arampersand/tasky/context/notes.md

```
---

## 🧪 Estado
- [x] Create core structure (`model`, `ui`, `wifi_portal`).
- [x] Centralize `enterScreen` logic.
- [x] Adapt to circular display (added `drawFrame` abstraction).
- [x] Fix QR screen blank issue (via `enterScreen`).
- [x] Fix LED on encoder issue (via `uiHaptic`).
- [x] Resolve C/C++ library conflicts with Nayuki QR code generator.
- [ ] Verify compilation and functionality on hardware.

---

## 📝 Licencia

Proyecto personal / experimental.  
Uso libre para aprendizaje y prototipos.

---

## ✨ Autor

Desarrollado por **Ary**  
Tasky – *Every second counts.*
