arampersand/tasky/cursor_context/00_MASTER_CONTEXT.md

# TaskyCircular – Master Context

TaskyCircular es un firmware para un dispositivo físico de productividad
con pantalla circular 240x240, encoder y WiFi.

Este proyecto está en transición de:
- Firmware funcional
→ Producto pulido con UX clara, animaciones y arquitectura mantenible.

NO es un experimento.
SÍ es un producto en camino a mercado.
