arampersand/tasky/cursor_context/01_PRODUCT_VISION.md

# Product Vision – Tasky

Tasky es un dispositivo de escritorio que hace visible:
- Tu foco
- Tus tareas
- Tu constancia (streak)

Sin depender del teléfono.

Principios:
- Calm tech
- Minimalismo funcional
- Todo feedback debe sentirse intencional
- El usuario nunca debe dudar qué hace el encoder
