arampersand/tasky/cursor_context/05_CONSTRAINTS.md

# Constraints

- Arduino IDE compatible (ESP32 core)
- No external frameworks
- No dynamic memory heavy solutions
- Prefer clarity over cleverness
- Keep modules separate (.h/.cpp)
- Avoid global drawing side effects
