arampersand/tasky/companion/README.md

# Tasky companion: AI agents on your desk

For **Tasky 3.0** or newer (or the 2.12+ **Tasky for Agents** firmware). Your coding agents report what they're doing, and Tasky shows it:

- **Agents** screen (it joins the MODE carousel when the first card arrives): one card per session with a little robot that shows its state (working / **waiting for you** / done) and the last message. Turn to go through the cards.
- **Approve from the knob:** when Claude Code asks permission ("run `npm test`?", "edit `ui.cpp`?"), Tasky jumps to that card. **Turn** to pick *Allow*, *Deny* or *Allow edits*, **press** to answer. **Long press** leaves the question to the terminal.
- The **light bar breathes** while an agent waits for you, plus a short beep (muted during focus sessions).
- **Home** says "1 agent needs you" instead of the phrase.

Tasky talks over the USB cable or, once paired, **over Wi-Fi**: plug it into the computer once and from then on it also works unplugged, on battery, anywhere on the same network (Tasky 3.1+).

## Set up (macOS / Linux)

1. Flash **Tasky 3.0 or newer** (or Tasky for Agents 2.12+) from https://tasky-flash.vercel.app.
2. Install the Tasky plugin. In Claude Code, run:
   ```
   /plugin marketplace add arampersand/tasky
   /plugin install tasky@tasky
   ```
3. Restart Claude Code. With Tasky plugged in, it shows a **Ready** card.

Something not working? Run `/tasky:status` in Claude Code: it checks everything and says what to fix.

The plugin lives in [`claude-plugin/`](../claude-plugin): six hooks, the `/tasky:status` skill and `tasky_agent.py`. Updates come through `/plugin`. To remove it: `/plugin uninstall tasky@tasky`.

Only Python 3 is needed (macOS: `xcode-select --install` if `python3` is missing). **Windows:** install Python from python.org (it brings the `py` launcher) and Git for Windows: Claude Code runs the plugin's hooks in Git Bash, and `hooks/run.sh` finds Python with `py -3`. Tasky shows up as a COM port (no driver needed on Windows 10/11). Tested with Claude Code 2.1.280; if hooks don't fire on an older version, update Claude Code (`claude update`).

### Without the plugin (terminal)

```bash
curl -fsSL https://tasky-flash.vercel.app/agents/install.sh | sh
```

It puts `tasky_agent.py` in `~/.tasky/` and adds the same hooks to `~/.claude/settings.json`. It backs the file up first (`settings.json.tasky-backup`) and leaves your other settings and hooks alone. Running it again updates it. To remove it: `curl -fsSL https://tasky-flash.vercel.app/agents/install.sh | sh -s -- --uninstall`

Use the plugin **or** the installer, not both: with both, every event reaches Tasky twice. If you switch to the plugin, run the uninstall command above (`tasky_agent.py doctor` warns about duplicate hooks).

| Claude Code event | What Tasky does |
|---|---|
| `SessionStart` | card: Ready |
| `UserPromptSubmit` | card: working |
| `PermissionRequest` | the question on the card: allow / deny with the knob |
| `Notification` (permission or input needed) | card: **waiting**, the light breathes |
| `Stop` | card: done |
| `SessionEnd` | card removed |

Sessions are named after the project folder. Tasky keeps up to 4 and forgets ones with no news for 2 hours.

### About approvals

- Claude Code runs the permission hook **before** it shows its own prompt. While a question is on Tasky, the terminal waits for it: up to **60 s** (`TASKY_ASK_TIMEOUT`), then the normal prompt appears. A long press on Tasky sends it to the terminal at once.
- If Tasky isn't plugged in, the hook returns immediately and you get the normal prompt. Nothing is ever approved by itself.
- *Allow edits* (for Edit/Write) also switches that session to accept edits, like choosing it in the terminal.
- Tasky can't answer Claude's multiple-choice questions or send it new messages: Claude Code hooks don't allow that.
- Anyone who can press the knob can approve. Keep that in mind on a shared desk.

## How it works

**Wi-Fi.** When Tasky 3.1+ is on USB, the daemon saves its pairing (device id and a random token) in `~/.tasky/link.json`, readable only by you. When Tasky isn't on USB, the daemon connects to it over TCP port 7778 and sends the token first; if Tasky's address changed, a UDP broadcast on the same port finds it again. Over Wi-Fi Tasky only accepts agent cards and questions, never settings. The token travels unencrypted on your local network, like most smart-home devices: anyone on that network who captures it could send cards to your Tasky, but approving still takes the knob. Unplug and replug to re-pair after a factory reset.

`tasky_agent.py daemon` (started on demand, quits after 2 hours without news) is the only program that opens Tasky's USB port. Hooks talk to it over a Unix socket in `~/.tasky/` that only you can open. That way a question can wait for the knob while other sessions keep reporting. It never toggles the port's DTR/RTS lines, so it never resets Tasky.

## Other agents and scripts

Anything that can run a command can report (with the plugin, the script is in Claude Code's plugin folder; any copy works, e.g. the one from the manual setup below):

```bash
python3 ~/.tasky/tasky_agent.py send --id deploy --label "Prod deploy" --state working --msg "Rolling out"
python3 ~/.tasky/tasky_agent.py send --id deploy --state done
python3 ~/.tasky/tasky_agent.py status    # is Tasky connected?
```

Protocol, one line over USB serial at 115200 baud (Tasky answers with lines starting `@tasky `):

```
TASKY AGENT {"id":"deploy","label":"Prod deploy","state":"working","msg":"Rolling out"}
TASKY ASK {"id":"r1","session":"deploy","label":"Prod deploy","tool":"Bash","detail":"kubectl apply","options":["Allow","Deny"],"timeout":60}
   -> @tasky {"answer":{"id":"r1","choice":0}}     (-1 = answer in the terminal)
TASKY ASK-CANCEL {"id":"r1"}
```

`state` is `working`, `waiting`, `done` or `end`. Text is ASCII (Tasky's fonts have no accents; the script simplifies them).

<details>
<summary>Manual setup (without the plugin or the installer)</summary>

```bash
mkdir -p ~/.tasky
curl -fsSL https://raw.githubusercontent.com/arampersand/tasky/main/claude-plugin/tasky_agent.py -o ~/.tasky/tasky_agent.py
python3 ~/.tasky/tasky_agent.py install       # or merge claude-hooks.json into ~/.claude/settings.json by hand
```
</details>

## Troubleshooting

- **First step:** `/tasky:status` in Claude Code, or `python3 ~/.tasky/tasky_agent.py doctor` in a terminal. It checks Python, Tasky on USB (and who holds the port), the firmware edition and version, and the hooks, then says what to fix.
- **Nothing shows up:** close the web setup page or any serial monitor: only one program can hold the port. If several USB devices are connected, set `TASKY_PORT=/dev/cu.usbmodemXXXX`.
- **Everything shows up twice:** the plugin and `install.sh` are both installed. Keep the plugin and run `curl -fsSL https://tasky-flash.vercel.app/agents/install.sh | sh -s -- --uninstall`.
- **Logs:** `~/.tasky/daemon.log`.
- **macOS asks to "identify your keyboard"** after you pair Tasky over Bluetooth (Controls screen): close that window. Tasky's shortcuts work anyway.

## Tests

```bash
python3 -m unittest discover companion/tests
```
They run the companion against a fake Tasky on a pseudo-terminal: status, allow / deny / allow edits, Tasky missing, timeout, a killed hook, concurrent sessions, and the settings.json installer.
