arampersand/tasky/claude-plugin/skills/status/SKILL.md

---
name: status
description: Check that Tasky (the desk gadget) is connected to Claude Code, and say exactly what to fix if it isn't. Use when the user asks whether Tasky works, why their Tasky shows nothing, or how to set it up.
---

Run this and show the user its output:

```bash
sh "${CLAUDE_PLUGIN_ROOT}/hooks/run.sh" doctor
```

(`run.sh` finds Python: `python3` on macOS / Linux, the `py` launcher on Windows. If it prints nothing at all, Python 3 isn't installed: on Windows, install it from python.org; on a Mac, run `xcode-select --install`.)

Each line is a check (✓ ok, ✗ problem). If something failed, tell the user the one fix the output suggests, in plain words, and offer to run it if it's a command. Common fixes:

- **No Tasky found:** plug Tasky into this computer with a data USB-C cable. Once it has been plugged in, it also works over Wi-Fi on the same network.
- **Port busy:** close the tab of tasky-flash.vercel.app (or the app named in the output) that holds Tasky's USB port.
- **Old firmware:** update Tasky at https://tasky-flash.vercel.app (it keeps the settings). Wi-Fi needs 3.1 or newer.
- **Hooks installed twice** (this plugin and `install.sh`): run `curl -fsSL https://tasky-flash.vercel.app/agents/install.sh | sh -s -- --uninstall`.

Don't change any files yourself.
