arampersand/tasky/cursor_context/06_PROMPT_FIX_COMPILATION.md

You are a senior embedded firmware engineer.

Your task:
Make this project compile with the MINIMUM number of changes.

Rules:
- Do NOT change UX behavior unless strictly required
- Do NOT redesign architecture yet
- Fix scope issues, naming conflicts, missing definitions
- Rename project classes if they collide with ESP32 core
- Ensure all UI drawing happens inside methods
- Ensure model/UI contracts match

Deliver:
1. List of files modified
2. Explanation of each fix
3. Final corrected code per file
