arampersand/tasky/firmware/tasky/agents_sprites.h

#pragma once
// The agent character on Tasky's Agents cards: Claude Code's little pixel
// crab (from its icon, a 16x10 grid in 1.5-unit steps), animated per state.
// '#' = body, '.' = background. Drawn x5 and tinted by state.

static const int SPRITE_W = 16, SPRITE_H = 10;

static const char *const SPRITE_WORK[2][SPRITE_H] = {
    {// walking: outer legs down
     "..############..", "..############..", "..##.######.##..", "..##.######.##..",
     "################", "################", "..############..", "..############..",
     "..#.#.....#.#...", "..#.......#....."},
    {// walking: inner legs down
     "..############..", "..############..", "..##.######.##..", "..##.######.##..",
     "################", "################", "..############..", "..############..",
     "..#.#.....#.#...", "....#.......#..."}};

static const char *const SPRITE_WAIT[2][SPRITE_H] = {
    {// right arm up
     "..############.#", "..############.#", "..##.######.####", "..##.######.####",
     "##############..", "##############..", "..############..", "..############..",
     "..#.#.....#.#...", "..#.#.....#.#..."},
    {// arms out
     "..############..", "..############..", "..##.######.##..", "..##.######.##..",
     "################", "################", "..############..", "..############..",
     "..#.#.....#.#...", "..#.#.....#.#..."}};

static const char *const SPRITE_DONE[2][SPRITE_H] = {
    {// happy, eyes closed
     "..############..", "..############..", "..############..", "..##.######.##..",
     "################", "################", "..############..", "..############..",
     "..#.#.....#.#...", "..#.#.....#.#..."},
    {// same pose, drawn one row higher: a little hop
     "..############..", "..############..", "..############..", "..##.######.##..",
     "################", "################", "..############..", "..############..",
     "..#.#.....#.#...", "..#.#.....#.#..."}};
