arampersand/tasky/TaskyCircular/wifi_portal.h

#pragma once

#include "model.h"
#include <Arduino.h>
#include <WebServer.h>
#include <WiFi.h>

class TaskyNetManager; // Forward declaration
class FocusDNS;        // Forward declaration
class OtaService;      // Forward declaration

class WiFiPortal {
public:
  WebServer server;
  FocusDNS* focusDns;   // Custom DNS with focus mode blocking
  OtaService* ota;      // OTA update service
  TaskyModel *model;
  TaskyNetManager *net;
  bool wifiOn = false;
  String apSSID = "Tasky";
  String apPass = "GetItDone";

  WiFiPortal(TaskyModel *m, TaskyNetManager *n, FocusDNS* dns, OtaService* otaSvc);

  void begin();
  void stop();
  void loop();

  String getUptimeString();

private:
  void handleRoot();
  void handleSave();
  void handleOtaUpload();
  void handleOtaStatus();
  String htmlPage();
};
