arampersand/tasky/(commit log)

2025-12-17 base version with mistakeserror on timer and navigation
2025-12-18 en caso de algo
2026-02-10 feat(main): Tasky modo usuario - oculta API keys, mensaje BLE para musica
2026-02-10 feat(main): UX sin API keys, Focus Mode diferenciado, menos parpadeo
    - Weather: saludo por hora (Buenos dias/tardes/noches) sin API key
    - Spotify: placeholder amigable en modo user
    - Focus Mode: UI clara con explicacion 'Bloquea redes en tu telefono'
    - Fix parpadeo: drawFocus solo actualiza tiempo cuando cambia (no cada 500ms)
    - Progress segments: solo redibujar cuando cambia el segmento
    - Flash feedback mas corto (50-80ms)
    - Timer: check cada 250ms en vez de 100ms
2026-02-25 feat: major UX overhaul - English UI, service timing fixes, new screens
    - Fix service timing: weather/calendar/github wait 10s for WiFi before
    first fetch, retry in 30s on failure instead of full interval
    - Reorder screens: Timer→Tasks→Calendar→Agenda→AI→Focus→Streak→Weather→Stats→Spotify→QR→Settings
    - Move WiFi into Settings (green/red status), remove from nav cycle
    - Invert encoder direction to match physical rotation
    - Agenda: show Today/Tomorrow with day names and calendar events
    - Calendar day detail: short press to view, full title wrap, better spacing
    - AI MODE selector: clean centered layout, no overlapping descriptions
    - Thinking animation: 3 sequential blink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
2026-02-25 fix: agenda auto-refresh, encoder direction, color tuning
    - Fix agenda not showing calendar events: auto-refresh when
    monthEventCount changes, force calendar update on click
    - Add Serial debug for agenda event matching
    - Fix pomodoro encoder direction (was inverted)
    - Calendar day colors: moderate busyness back to orange/yellow
    - Weather sun icon back to orange/yellow
    - Agenda Tomorrow header stays purple
2026-10-15 feat: focus mode rework, workday brief, per-task focus minutes
    - Remove DNS-based focus blocking (focus_dns) and power_manager
    - Focus mode: light bar + MODO lock while a work session runs
    - Morning brief / day close based on configurable workday hours
    - Track focus minutes per task and current task for the timer
    - Calendar helpers: next event today, first event on day
    Claude-Session: https://claude.ai/code/session_01G1Q3y6LaDqkadxcPaKwcUN
2026-10-15 docs(plan): reference prepared photos, AI render and 3D device component
    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
2026-10-15 chore: monorepo layout, version.h, merged flash image, device photos
    - TaskyCircular/ -> firmware/tasky/ (tasky.ino), platformio.ini -> firmware/
    - version.h as single source of truth (2.4.0)
    - scripts/merge_bin.py emits tasky-<env>-merged.bin at offset 0x0
    - config_secrets.h.example
    - docs/images: cropped device photos; web/public/device: 3D <tasky-device>
    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
2026-10-15 feat(web): landing page + browser flasher (ESP Web Tools)
    - fetch-firmware.mjs pulls the latest GitHub Release at Vercel build time
    so binaries are served same-origin (release assets have no CORS)
    - board selector (XIAO C3/C6), release notes, after-flash steps
    - hero uses the interactive <tasky-device> 3D model; real photo gallery
    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
2026-10-15 fix(ota): portal upload always failed with 'Not enough space'
    WebServer reports upload.totalSize = 0 at UPLOAD_FILE_START, so the
    3 MB fallback was passed to Update.begin(), larger than the 1.875 MB
    OTA slot. Begin with UPDATE_SIZE_UNKNOWN and estimate progress from the
    request Content-Length.
    Also adds docs/IMPROVEMENTS.md (known issues + prioritized proposals).
    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
2026-10-16 feat(portal): per-device AP password, LAN login, redacted logs; roadmap
    - Setup AP password generated per device on first boot (NVS 'app'),
    shown under the QR and on WiFi/Update screens; GetItDone removed
    - LAN access needs Basic auth (tasky + device password); Host must be the
    device IP and Origin/Referer must match (CSRF, DNS rebinding)
    - redactUrl() trims URLs in serial logs (private iCal address)
    - Factory reset also erases WiFi driver credentials
    - docs/ROADMAP.md: Tasky 3.0, Desk/Go variants, early user feedback
    - Bump to 2.5.0
    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
2026-10-16 feat: Home glance screen + web setup wizard over USB (2.6.0, 3.0 beta)
    Firmware
    - SCR_HOME first in the carousel: clock, date + weather, next event, open
    tasks, rotating phrase; press = start focus, long press = tasks
    - Ambient shares the Home layout (refreshGlance), no idle switch on Home
    - UsbSetup: TASKY? / TASKY SCAN / TASKY SET {json} over USB serial,
    ArduinoJson 7; refreshes weather/calendar after a SET
    Web
    - 'Set up' wizard on tasky-flash: connect -> Wi-Fi scan -> calendar ->
    tasks -> GitHub -> AI -> weather -> done, time zone from the browser
    - 3D model shows the Home screen
    Docs: manual (web setup, Home), roadmap progress, changelog, building
    (ArduinoJson), architecture (USB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
2026-10-16 feat: Tasky for Agents edition, clock from browser/phone, editions on web (2.7.0)
    - Second firmware (envs xiao_c3_agents / xiao_c6_agents, NimBLE-Arduino):
    Agents screen (Claude Code status via TASKY AGENT over USB, breathing
    light + beep when waiting), Controls screen (BLE HID volume/brightness/
    media/shortcuts); drops LLM + Notion to fit
    - companion/: tasky_agent.py (Claude Code hooks, pyserial), hooks JSON, README
    - Clock without internet: TASKY SET time + portal /time from the phone
    - Web: firmware picker (Tasky / Tasky for Agents), editions section,
    studio renders; wizard skips AI step on Agents edition
    - CI/release matrix: 4 envs; fetch-firmware handles optional agents builds
    -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
2026-10-16 feat: RGB light bar option, PCB docs, Go hardware plan (2.8.0)
    - Runtime light type (NVS ledT, USB SET "light"): plain LED via PWM or an
    SK6812 chain via RMT; new "Light" step in the web setup.
    - docs/HARDWARE.md: v1.1 and v3.1 carrier boards + schematic.
    - docs/ROADMAP.md: Tasky Go plan from the real boards.
    - Web flasher: Agents manifests named "Tasky for Agents".
    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
2026-10-16 feat: first-boot tour and on-screen hints (2.9.0)
    - Interactive 4-step tour (turn, press, MODE, done); hold MODE to skip,
    replay from More -> Tour; devices already in use skip it on upgrade.
    - One-line hint pill on the first 3 visits of each screen; hides after
    3 s or on input, before the handler runs so it never undoes an action.
    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
2026-10-16 feat(web): USB picker lists only Tasky
    Filter Web Serial's port picker to Espressif's USB-Serial/JTAG (VID 0x303A)
    for both the installer and the setup wizard, name the entry to pick, show
    when a known Tasky is plugged in, explain "Erase device", and keep a
    "Show every port" escape hatch.
    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
2026-10-16 fix: one knob step per detent, no full-screen flash (2.10.0)
    - Encoder decoded on interrupts in encoder.cpp (IRAM ISR, DRAM table);
    ENCODER_TICKS_PER_DETENT sets edges per click.
    - Settings, Tasks, More, Focus and Calendar repaint only the rows that
    changed; the Timer repaints just its digits when you turn the knob.
    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
2026-10-16 feat: computer companion — approvals from the knob, agent cards, key row (2.12.0)
    - Claude Code PermissionRequest hook answered on Tasky (TASKY ASK /
    ASK-CANCEL); companion daemon owns the USB port (termios, no pyserial),
    hooks talk over ~/.tasky/agent.sock; one-command install.sh + `install`.
    - Agent cards with Claude Code's pixel character, animated per state.
    - Controls: Mac/Windows key wheel with volume/brightness dials.
    - ~50 quotes with authors; streak greens from daily activity; streak day
    persisted across power-off; QR and Streak in the default carousel.
    - partitions.csv: two 1.9375 MiB app slots (update once from the web).
    - Web: Agents step (command, test card, Disconnect);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
2026-10-16 feat: easy setup and polish (2.13.0)
    - Claude Code plugin: /plugin marketplace add arampersand/tasky,
    /plugin install tasky@tasky (Ready card, /tasky:status + doctor,
    dedupe with install.sh); tasky_agent.py moved to claude-plugin/.
    - Web setup: calendar helper (Google/iCloud/Outlook) + Test it via
    TASKY CALTEST, GitHub "Is this you?" preview, plugin-first agents step,
    jump to setup after flashing.
    - Bilingual phone portal (English/Spanish) mirroring the web wizard.
    - Device: carousel dots, Home day bar + "Set me up", calm rest screen
    with quotes, quick settings (Home long press), two-page streak (yours /
    GitHub, migrated once from 2.12), weather empty states, agent banner,
    sett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
2026-10-16 feat: Tasky 3.0 — one firmware with everything (3.0.0)
    - One firmware for XIAO C3 and C6: focus timer, tasks, calendar, weather,
    GitHub streak, Notion, AI daily brief, Claude Code agent cards and
    knob approvals, and the Bluetooth key row (Mac / Windows / Phone).
    Bluetooth starts the first time you open Controls.
    - More > Screens: start screen and carousel order on the device.
    - Daily brief: the AI's "Today" mode in the morning notice.
    - Bigger, scannable Setup (QR); screen number in the corner; display
    black first at boot; Calendar in the default carousel.
    - Printable quick-start card at /start; web flasher asks only the board.
    - C6 fits its app slot again (CORE_DEBUG_LEVEL=0); CI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
2026-10-16 feat: More inside Settings, new screen order, bigger page number (3.0.1)
    - More is the first row of Settings instead of a separate last screen;
    MODE from More goes back to Settings. If Settings leaves the carousel,
    More comes back at the end.
    - Default order: Home, Timer, Tasks, Agenda, Calendar, Streak, Weather,
    Agents, Controls, Phrases, Settings, Setup (QR).
    - Bigger page number in the corner, repainted without flicker.
    - Docs, web and portal text say Settings > More.
    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
2026-10-16 feat: Claude Code over Wi-Fi, calmer Home, full GitHub streak (3.1.0, unreleased)
    - Wi-Fi companion link: TCP 7778 with a per-device token (paired over USB
    in TASKY? "link"), UDP discovery, pending slot so strangers can't kick
    the paired computer; only agent cards / questions over Wi-Fi. The plugin
    saves ~/.tasky/link.json (0600) and falls back to Wi-Fi when Tasky isn't
    on USB. Tests for pairing, cards and questions, rediscovery, bad token.
    - Home: date top-left, weather top-right, centered clock, focus bar, one
    task.
    - GitHub streak from the profile contribution graph (private
    contributions included), streamed line by line.
    - Controls: mode remembered per Bluetooth device; phone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
2026-10-16 fix: Wi-Fi replies, device memory, cards after a restart; Bluetooth setup step
    - Replies are one write each (byte-by-byte JSON over TCP was one packet
    per byte) and keep their "@tasky " prefix (serializeJson into a String
    replaces its content).
    - Controls: a new Bluetooth device is remembered with the current mode at
    once; identity keys are exchanged so a Mac or phone with a private
    address is recognized; private addresses no longer count as new.
    - Companion: replays each session's last card after a reconnect (Tasky
    restarted or replugged); TASKY_WIFI_RETRY for tests.
    - Web setup: Bluetooth step (TASKY BT turns it on and opens Controls,
    TASKY BT? watches for the pairing); Home we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
2026-10-16 feat: complete onboarding, setup that remembers, plain-language site (3.1.0)
    - Device tour: Connect (web over USB, or the phone's QR) and a Set up
    checklist (Wi-Fi, calendar, tasks, weather, AI brief) that ticks itself;
    skipped when Tasky is already online.
    - Web setup: summary of what's saved for a configured Tasky, jump to any
    step, remembers plain fields in the browser (never secrets), keeps the
    saved Wi-Fi password, AI brief step.
    - Phone portal: AI brief explained.
    - Site copy rewritten in plain language (index, /claude, /start).
    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
